ahmedqamesh/mopshub_readout/vivado/mopshub_readout/mopshub_readout/mopshub_readout.runs/mopshub_readout_bd_clk_wiz_0_0_synth_1/.vivado.begin.rst

<?xml version="1.0"?>
<ProcessHandle Version="1" Minor="0">
    <Process Command="vivado" Owner="dcs" Host="localhost.localdomain" Pid="18536" HostCore="8" HostMemory="32717760">
    </Process>
</ProcessHandle>
