ahmedqamesh/mopshub_readout/vivado/mopshub_readout/mopshub_readout/mopshub_readout.runs/mopshub_readout_bd_gig_ethernet_pcs_pma_0_0_synth_1/.Xil/mopshub_readout_bd_gig_ethernet_pcs_pma_0_0_propImpl.xdc

set_property SRC_FILE_INFO {cfile:/home/dcs/git/mopshub_readout/Vivado/mopshub_readout/mopshub_readout/mopshub_readout.gen/sources_1/bd/mopshub_readout_bd/ip/mopshub_readout_bd_gig_ethernet_pcs_pma_0_0/ip_0/synth/mopshub_readout_bd_gig_ethernet_pcs_pma_0_0_gt.xdc rfile:../../../mopshub_readout.gen/sources_1/bd/mopshub_readout_bd/ip/mopshub_readout_bd_gig_ethernet_pcs_pma_0_0/ip_0/synth/mopshub_readout_bd_gig_ethernet_pcs_pma_0_0_gt.xdc id:1 order:EARLY scoped_inst:inst/pcs_pma_block_i/transceiver_inst/mopshub_readout_bd_gig_ethernet_pcs_pma_0_0_gt_i/inst} [current_design]
set_property SRC_FILE_INFO {cfile:/home/dcs/git/mopshub_readout/Vivado/mopshub_readout/mopshub_readout/mopshub_readout.gen/sources_1/bd/mopshub_readout_bd/ip/mopshub_readout_bd_gig_ethernet_pcs_pma_0_0/synth/mopshub_readout_bd_gig_ethernet_pcs_pma_0_0.xdc rfile:../../../mopshub_readout.gen/sources_1/bd/mopshub_readout_bd/ip/mopshub_readout_bd_gig_ethernet_pcs_pma_0_0/synth/mopshub_readout_bd_gig_ethernet_pcs_pma_0_0.xdc id:2 order:LATE scoped_inst:inst} [current_design]
set_property src_info {type:SCOPED_XDC file:1 line:58 export:INPUT save:INPUT read:READ} [current_design]
set_case_analysis 1 [get_pins {inst/pcs_pma_block_i/transceiver_inst/mopshub_readout_bd_gig_ethernet_pcs_pma_0_0_gt_i/inst/gen_gtwizard_gthe4_top.mopshub_readout_bd_gig_ethernet_pcs_pma_0_0_gt_gtwizard_gthe4_inst/gen_gtwizard_gthe4.gen_channel_container[27].gen_enabled_channel.gthe4_channel_wrapper_inst/channel_inst/gthe4_channel_gen.gen_gthe4_channel_inst[0].GTHE4_CHANNEL_PRIM_INST/TXOUTCLKSEL[2]}]
set_property src_info {type:SCOPED_XDC file:1 line:59 export:INPUT save:INPUT read:READ} [current_design]
set_case_analysis 0 [get_pins {inst/pcs_pma_block_i/transceiver_inst/mopshub_readout_bd_gig_ethernet_pcs_pma_0_0_gt_i/inst/gen_gtwizard_gthe4_top.mopshub_readout_bd_gig_ethernet_pcs_pma_0_0_gt_gtwizard_gthe4_inst/gen_gtwizard_gthe4.gen_channel_container[27].gen_enabled_channel.gthe4_channel_wrapper_inst/channel_inst/gthe4_channel_gen.gen_gthe4_channel_inst[0].GTHE4_CHANNEL_PRIM_INST/TXOUTCLKSEL[1]}]
set_property src_info {type:SCOPED_XDC file:1 line:60 export:INPUT save:INPUT read:READ} [current_design]
set_case_analysis 1 [get_pins {inst/pcs_pma_block_i/transceiver_inst/mopshub_readout_bd_gig_ethernet_pcs_pma_0_0_gt_i/inst/gen_gtwizard_gthe4_top.mopshub_readout_bd_gig_ethernet_pcs_pma_0_0_gt_gtwizard_gthe4_inst/gen_gtwizard_gthe4.gen_channel_container[27].gen_enabled_channel.gthe4_channel_wrapper_inst/channel_inst/gthe4_channel_gen.gen_gthe4_channel_inst[0].GTHE4_CHANNEL_PRIM_INST/TXOUTCLKSEL[0]}]
set_property src_info {type:SCOPED_XDC file:1 line:63 export:INPUT save:INPUT read:READ} [current_design]
set_case_analysis 0 [get_pins {inst/pcs_pma_block_i/transceiver_inst/mopshub_readout_bd_gig_ethernet_pcs_pma_0_0_gt_i/inst/gen_gtwizard_gthe4_top.mopshub_readout_bd_gig_ethernet_pcs_pma_0_0_gt_gtwizard_gthe4_inst/gen_gtwizard_gthe4.gen_channel_container[27].gen_enabled_channel.gthe4_channel_wrapper_inst/channel_inst/gthe4_channel_gen.gen_gthe4_channel_inst[0].GTHE4_CHANNEL_PRIM_INST/RXOUTCLKSEL[2]}]
set_property src_info {type:SCOPED_XDC file:1 line:64 export:INPUT save:INPUT read:READ} [current_design]
set_case_analysis 1 [get_pins {inst/pcs_pma_block_i/transceiver_inst/mopshub_readout_bd_gig_ethernet_pcs_pma_0_0_gt_i/inst/gen_gtwizard_gthe4_top.mopshub_readout_bd_gig_ethernet_pcs_pma_0_0_gt_gtwizard_gthe4_inst/gen_gtwizard_gthe4.gen_channel_container[27].gen_enabled_channel.gthe4_channel_wrapper_inst/channel_inst/gthe4_channel_gen.gen_gthe4_channel_inst[0].GTHE4_CHANNEL_PRIM_INST/RXOUTCLKSEL[1]}]
set_property src_info {type:SCOPED_XDC file:1 line:65 export:INPUT save:INPUT read:READ} [current_design]
set_case_analysis 0 [get_pins {inst/pcs_pma_block_i/transceiver_inst/mopshub_readout_bd_gig_ethernet_pcs_pma_0_0_gt_i/inst/gen_gtwizard_gthe4_top.mopshub_readout_bd_gig_ethernet_pcs_pma_0_0_gt_gtwizard_gthe4_inst/gen_gtwizard_gthe4.gen_channel_container[27].gen_enabled_channel.gthe4_channel_wrapper_inst/channel_inst/gthe4_channel_gen.gen_gthe4_channel_inst[0].GTHE4_CHANNEL_PRIM_INST/RXOUTCLKSEL[0]}]
current_instance inst/pcs_pma_block_i/transceiver_inst/mopshub_readout_bd_gig_ethernet_pcs_pma_0_0_gt_i/inst
set_property src_info {type:SCOPED_XDC file:1 line:68 export:INPUT save:INPUT read:READ} [current_design]
set_property LOC GTHE4_CHANNEL_X1Y14 [get_cells -hierarchical -filter {NAME =~ *gen_channel_container[27].*gen_gthe4_channel_inst[0].GTHE4_CHANNEL_PRIM_INST}]
current_instance
set_property src_info {type:SCOPED_XDC file:1 line:84 export:INPUT save:INPUT read:READ} [current_design]
set_case_analysis 1 [get_pins {inst/pcs_pma_block_i/transceiver_inst/mopshub_readout_bd_gig_ethernet_pcs_pma_0_0_gt_i/inst/gen_gtwizard_gthe4_top.mopshub_readout_bd_gig_ethernet_pcs_pma_0_0_gt_gtwizard_gthe4_inst/gen_gtwizard_gthe4.gen_pwrgood_delay_inst[0].delay_powergood_inst/gen_powergood_delay.pwr_on_fsm_reg/Q}]
current_instance inst/pcs_pma_block_i/transceiver_inst/mopshub_readout_bd_gig_ethernet_pcs_pma_0_0_gt_i/inst
set_property src_info {type:SCOPED_XDC file:1 line:88 export:INPUT save:INPUT read:READ} [current_design]
create_waiver -internal -quiet -user gtwizard_ultrascale -tags 1025417 -type METHODOLOGY -id TIMING-3 -description "added waiver for CPLL CAL local BUFG_GT usecase"  -scope -objects [get_pins -filter {REF_PIN_NAME=~*O} -of_objects [get_cells -hierarchical -filter {NAME =~ *gen_cpll_cal_inst[*].*bufg_gt_*xoutclkmon_inst}]]
set_property src_info {type:SCOPED_XDC file:1 line:90 export:INPUT save:INPUT read:READ} [current_design]
create_waiver -internal -quiet -type CDC -id {CDC-11} -user gtwizard_ultrascale -tags "1074717" -description "CDC-11 waiver for CPLL Calibration logic" -scope -from [get_pins -quiet -filter {REF_PIN_NAME=~*C} -of_objects [get_cells -hierarchical -filter {NAME =~*OUTCLK_FREQ_COUNTER/state_reg[0]}]]  -to [get_pins -quiet -filter {REF_PIN_NAME=~*PRE} -of_objects [get_cells -hierarchical -filter {NAME =~*OUTCLK_FREQ_COUNTER/reset_synchronizer_testclk_rst_inst/rst_in_meta_reg*}]]
set_property src_info {type:SCOPED_XDC file:1 line:91 export:INPUT save:INPUT read:READ} [current_design]
create_waiver -internal -quiet -type CDC -id {CDC-11} -user gtwizard_ultrascale -tags "1074717" -description "CDC-11 waiver for CPLL Calibration logic" -scope -from [get_pins -quiet -filter {REF_PIN_NAME=~*C} -of_objects [get_cells -hierarchical -filter {NAME =~*OUTCLK_FREQ_COUNTER/state_reg[0]}]]  -to [get_pins -quiet -filter {REF_PIN_NAME=~*D} -of_objects [get_cells -hierarchical -filter {NAME =~*OUTCLK_FREQ_COUNTER/tstclk_rst_dly1_reg*}]]
current_instance
current_instance inst
set_property src_info {type:SCOPED_XDC file:2 line:18 export:INPUT save:INPUT read:READ} [current_design]
create_waiver -internal -scope -quiet -type CDC -id {CDC-10} -user "gig_ethernet_pcs_pma" -tags "11999" -desc "The CDC-10 warning is waived as this is within the GT Wizard" -from [get_pins -of [get_cells -hier -filter {name =~ */gpcs_pma_inst/USE_ROCKET_IO.RX_RST_SM_TXOUTCLK.MGT_RX_RESET_INT_reg*}] -filter {name =~ *C}] -to [get_pins -of [get_cells -hier -filter {name =~ */gen_gtwizard_*.gen_reset_controller_internal.gen_single_instance.gtwiz_reset_inst/reset_synchronizer_gtwiz_reset_rx_*_inst/rst_in_meta_reg*}] -filter {name =~ *PRE}]
set_property src_info {type:SCOPED_XDC file:2 line:22 export:INPUT save:INPUT read:READ} [current_design]
create_waiver -internal -scope -quiet -type CDC -id {CDC-10} -user "gig_ethernet_pcs_pma" -tags "11999" -desc "The CDC-10 warning is waived as this is within the GT Wizard" -from [get_pins -of [get_cells -hier -filter {name =~ */gpcs_pma_inst/USE_ROCKET_IO.MGT_TX_RESET_INT_reg*}] -filter {name =~ *C}] -to [get_pins -of [get_cells -hier -filter {name =~ */gen_gtwizard_*.gen_reset_controller_internal.gen_single_instance.gtwiz_reset_inst/reset_synchronizer_gtwiz_reset_tx_*_inst/rst_in_meta_reg*}] -filter {name =~ *PRE}]
set_property src_info {type:SCOPED_XDC file:2 line:26 export:INPUT save:INPUT read:READ} [current_design]
create_waiver -internal -scope -quiet -type CDC -id {CDC-10} -user "gig_ethernet_pcs_pma" -tags "11999" -desc "The CDC-10 warning is waived as this is within the GT Wizard" -from [get_pins -of [get_cells -hier -filter {name =~ */*_data_rx/reset_sync6*}] -filter {name =~ *C}] -to [get_pins -of [get_cells -hier -filter {name =~ */gen_gtwizard_*.gen_reset_controller_internal.gen_single_instance.gtwiz_reset_inst/reset_synchronizer_gtwiz_reset_*x_*_inst/rst_in_meta_reg*}] -filter {name =~ *PRE}]
set_property src_info {type:SCOPED_XDC file:2 line:30 export:INPUT save:INPUT read:READ} [current_design]
create_waiver -internal -scope -quiet -type CDC -id {CDC-10} -user "gig_ethernet_pcs_pma" -tags "11999" -desc "The CDC-10 warning is waived as this is within the GT Wizard" -from [get_pins -of [get_cells -hier -filter {name =~ */gen_gtwizard_*.gen_reset_controller_internal.gen_single_instance.gtwiz_reset_inst/reset_synchronizer_*x_done_inst/rst_in_out_reg*}] -filter {name =~ *C}] -to [get_pins -of [get_cells -hier -filter {name =~ */gen_gtwizard_*.gen_reset_controller_internal.gen_single_instance.gtwiz_reset_inst/reset_synchronizer_gtwiz_reset_*x_*_inst/rst_in_meta_reg*}] -filter {name =~ *PRE}]
set_property src_info {type:SCOPED_XDC file:2 line:33 export:INPUT save:INPUT read:READ} [current_design]
create_waiver -internal -scope -quiet -type CDC -id {CDC-12} -user "gig_ethernet_pcs_pma" -tags "11999" -desc "The CDC-12 warning is waived as this is within the GT Wizard" -from [get_pins -of [get_cells -hier -filter {name =~ */gen_gtwizard_*.gen_reset_controller_internal.gen_single_instance.gtwiz_reset_inst/reset_synchronizer_*x_done_inst/rst_in_out_reg*}] -filter {name =~ *C}] -to [get_pins -of [get_cells -hier -filter {name =~ */gen_gtwizard_*.gen_reset_controller_internal.gen_single_instance.gtwiz_reset_inst/reset_synchronizer_gtwiz_reset_*x_*_inst/rst_in_meta_reg*}] -filter {name =~ *PRE}]
set_property src_info {type:SCOPED_XDC file:2 line:36 export:INPUT save:INPUT read:READ} [current_design]
create_waiver -internal -scope -quiet -type CDC -id {CDC-10} -user "gig_ethernet_pcs_pma" -tags "11999" -desc "The CDC-10 warning is waived as this is within the GT Wizard" -from [get_pins -of [get_cells -hier -filter {name =~ */transceiver_inst/gtwiz_reset_*x_done_*_int_reg_reg*}] -filter {name =~ *C}] -to [get_pins -of [get_cells -hier -filter {name =~ */reset_synchronizer_gtwiz_reset_*x_*_inst/rst_in_meta_reg*}] -filter {name =~ *PRE}]
set_property src_info {type:SCOPED_XDC file:2 line:40 export:INPUT save:INPUT read:READ} [current_design]
create_waiver -internal -scope -quiet -type CDC -id {CDC-10} -user "gig_ethernet_pcs_pma" -tags "11999" -desc "The CDC-10 warning is waived as this is within the GT Wizard" -from [get_pins -of [get_cells -hier -filter {name =~ */reset_synchronizer_rx_done_inst/rst_in_out_reg*}] -filter {name =~ *C}] -to [get_pins -of [get_cells -hier -filter {name =~ */sync_block_reset_done/data_sync_reg1*}] -filter {name =~ *D}]
set_property src_info {type:SCOPED_XDC file:2 line:44 export:INPUT save:INPUT read:READ} [current_design]
create_waiver -internal -scope -quiet -type CDC -id {CDC-11} -user "gig_ethernet_pcs_pma" -tags "11999" -desc "The CDC-11 warning is waived as this is within the GT Wizard" -from [get_pins -of [get_cells -hier -filter {name =~ */U_TXOUTCLK_FREQ_COUNTER/state_reg[0]*}] -filter {name =~ *C}] -to [list [get_pins -of [get_cells -hier -filter {name =~ */U_TXOUTCLK_FREQ_COUNTER/reset_synchronizer_testclk_rst_inst/rst_in_meta_reg*}] -filter {name =~ *PRE}] [get_pins -of [get_cells -hier -filter {name =~ */U_TXOUTCLK_FREQ_COUNTER/tstclk_rst_dly1_reg*}] -filter {name =~ *D}] ]
set_property src_info {type:SCOPED_XDC file:2 line:48 export:INPUT save:INPUT read:READ} [current_design]
create_waiver -internal -scope -quiet -type CDC -id {CDC-10} -user "gig_ethernet_pcs_pma" -tags "11999" -desc "The CDC-10 warning is waived as this is within the GT Wizard" -from [get_pins -of [get_cells -hier -filter {name =~ */gen_gtwizard_*.gen_rx_buffer_bypass_internal.gen_single_instance.gtwiz_buffbypass_rx_inst/gen_gtwiz_buffbypass_rx_main.gen_auto_mode.gtwiz_buffbypass_rx_done_out_reg*}] -filter {name =~ *C}] -to [get_pins -of [get_cells -hier -filter {name =~ */sync_block_reset_done/data_sync_reg1*}] -filter {name =~ *D}]
set_property src_info {type:SCOPED_XDC file:2 line:50 export:INPUT save:INPUT read:READ} [current_design]
create_waiver -internal -scope -quiet -type CDC -id {CDC-10} -user "gig_ethernet_pcs_pma" -tags "11999" -desc "The CDC-10 warning is waived as this is within the GT Wizard" -from [get_pins -of [get_cells -hier -filter {name =~ */SYNC_UNIDIRECTIONAL_ENABLE_RXOUTCLK_INST/data_sync_reg6*}] -filter {name =~ *C}] -to [get_pins -of [get_cells -hier -filter {name =~ */SYNC_XMIT_*_TXOUTCLK/data_sync_reg1*}] -filter {name =~ *D}]
set_property src_info {type:SCOPED_XDC file:2 line:54 export:INPUT save:INPUT read:READ} [current_design]
create_waiver -internal -scope -quiet -type CDC -id {CDC-13} -user "gig_ethernet_pcs_pma" -tags "11999" -desc "The CDC-13 warning is waived as this is within the GT Wizard" -from [get_pins -of [get_cells -hier -filter {name =~ */reclock_encommaalign/reset_sync6*}] -filter {name =~ *C}] -to [get_pins -of [get_cells -hier -filter {name =~ */gt*_channel_gen.gen_gt*_channel_inst[0].GT*_CHANNEL_PRIM_INST*}] -filter {name =~ *RX*COMMAALIGNEN}]
set_property src_info {type:SCOPED_XDC file:2 line:56 export:INPUT save:INPUT read:READ} [current_design]
create_waiver -internal -scope -quiet -type CDC -id {CDC-10} -user "gig_ethernet_pcs_pma" -tags "11999" -desc "The CDC-10 warning is waived as this is within the GT Wizard" -from [get_pins  -of [get_cells -hier -filter {name =~ */reset_synchronizer_tx_done_inst/rst_in_out_reg*}] -filter {name =~ *C}] -to [get_pins  -of [get_cells -hier -filter {name =~ */sync_block_reset_done/data_sync_reg1*}] -filter {name =~ *D}]
