ahmedqamesh/mopshub_readout/vivado/mopshub_readout/mopshub_readout/mopshub_readout.runs/mopshub_readout_bd_mopshub_readout_0_0_synth_1/.Xil/mopshub_readout_bd_mopshub_readout_0_0_propImpl.xdc

set_property SRC_FILE_INFO {cfile:/home/dcs/git/mopshub_readout/Vivado/mopshub_readout/ip_repo/tri_mode_ethernet_mac_0/synth/tri_mode_ethernet_mac_0.xdc rfile:../../../../ip_repo/tri_mode_ethernet_mac_0/synth/tri_mode_ethernet_mac_0.xdc id:1 order:EARLY scoped_inst:inst/ethernet_core0/ethernet_emac_wrapper0/mac/inst} [current_design]
current_instance inst/ethernet_core0/ethernet_emac_wrapper0/mac/inst
set_property src_info {type:SCOPED_XDC file:1 line:51 export:INPUT save:INPUT read:READ} [current_design]
create_waiver -internal -scope -quiet -type CDC -id {CDC-11} -user "tri_mode_ethernet_mac" -tags "11999" -desc "Part of reset synchronizer. Safe to ignore" -from [get_pins -of [get_cells -hier -filter {name =~ */sync_stats_reset/sync_rst1_reg*}] -filter {name =~ *C}] -to [get_pins -of [get_cells -hier -filter {name =~ */SYNC_STATS_RESET/async_rst0_reg*}] -filter {name =~ *PRE}]
set_property src_info {type:SCOPED_XDC file:1 line:52 export:INPUT save:INPUT read:READ} [current_design]
create_waiver -internal -scope -quiet -type CDC -id {CDC-1} -user "tri_mode_ethernet_mac" -tags "11999" -desc "Safe to ignore. This data-bus is read-date port of the LUT based RAM whose read address is generated in the destination clock domain." -from [get_pins -of [get_cells -hier -filter {name =~ */byte_wide_ram[*].header_compare_dist_ram/DP*}] -filter {name =~ *CLK}] -to [get_pins -of [get_cells -hier -filter {name =~ */bit_match_gen[*].bit_match_reg[*]*}] -filter {name =~ *D}]
set_property src_info {type:SCOPED_XDC file:1 line:53 export:INPUT save:INPUT read:READ} [current_design]
create_waiver -internal -scope -quiet -type CDC -id {CDC-1} -user "tri_mode_ethernet_mac" -tags "11999" -desc "Safe to ignore. This data-bus is read-date port of the LUT based RAM whose read address is generated in the destination clock domain." -from [get_pins -of [get_cells -hier -filter {name =~ */man_block.managen/conf/int_rx_pause_ad_reg[*]*}] -filter {name =~ *C}] -to [get_pins -of [get_cells -hier -filter {name =~ */address_filter_inst/load_wr_data_reg[*]*}] -filter {name =~ *D}]
set_property src_info {type:SCOPED_XDC file:1 line:54 export:INPUT save:INPUT read:READ} [current_design]
create_waiver -internal -scope -quiet -type CDC -id {CDC-1} -user "tri_mode_ethernet_mac" -tags "11999" -desc "Control register o/p expected to be static during MAC operations and thus a false path for all practical purposes and thus can be ignored" -from [get_pins -of [get_cells -hier -filter {name =~ */man_block.managen/conf/int_rx_en_reg*}] -filter {name =~ *C}] -to [get_pins -of [get_cells -hier -filter {name =~ */rxgen/ENABLE_REG_reg*}] -filter {name =~ *D}]
set_property src_info {type:SCOPED_XDC file:1 line:55 export:INPUT save:INPUT read:READ} [current_design]
create_waiver -internal -scope -quiet -type CDC -id {CDC-1} -user "tri_mode_ethernet_mac" -tags "11999" -desc "Control register o/p expected to be static during MAC operations and thus a false path for all practical purposes and thus can be ignored" -from [get_pins -of [get_cells -hier -filter {name =~ */man_block.managen/conf/int_*x_inband_*_enable_reg*}] -filter {name =~ *C}]
