ahmedqamesh/mopshub_readout/vivado/mopshub_readout/mopshub_readout/mopshub_readout.cache/ip/2020.2/126f6c86148f7189/mopshub_readout_bd_gig_ethernet_pcs_pma_0_0_stub.v

// Copyright 1986-2020 Xilinx, Inc. All Rights Reserved.
// --------------------------------------------------------------------------------
// Tool Version: Vivado v.2020.2 (lin64) Build 3064766 Wed Nov 18 09:12:47 MST 2020
// Date        : Fri May  3 17:18:30 2024
// Host        : localhost.localdomain running 64-bit unknown
// Command     : write_verilog -force -mode synth_stub -rename_top decalper_eb_ot_sdeen_pot_pi_dehcac_xnilix -prefix
//               decalper_eb_ot_sdeen_pot_pi_dehcac_xnilix_ mopshub_readout_bd_gig_ethernet_pcs_pma_0_0_stub.v
// Design      : mopshub_readout_bd_gig_ethernet_pcs_pma_0_0
// Purpose     : Stub declaration of top-level module interface
// Device      : xczu9eg-ffvb1156-2-e
// --------------------------------------------------------------------------------

// This empty module with port declaration file causes synthesis tools to infer a black box for IP.
// The synthesis directives are for Synopsys Synplify support to prevent IO buffer insertion.
// Please paste the declaration into a Verilog source file or add the file as an additional source.
module decalper_eb_ot_sdeen_pot_pi_dehcac_xnilix(gtrefclk_p, gtrefclk_n, gtrefclk_out, txp, txn, 
  rxp, rxn, resetdone, userclk_out, userclk2_out, rxuserclk_out, rxuserclk2_out, 
  independent_clock_bufg, pma_reset_out, mmcm_locked_out, gmii_txd, gmii_tx_en, gmii_tx_er, 
  gmii_rxd, gmii_rx_dv, gmii_rx_er, gmii_isolate, configuration_vector, status_vector, reset, 
  gtpowergood, signal_detect)
/* synthesis syn_black_box black_box_pad_pin="gtrefclk_p,gtrefclk_n,gtrefclk_out,txp,txn,rxp,rxn,resetdone,userclk_out,userclk2_out,rxuserclk_out,rxuserclk2_out,independent_clock_bufg,pma_reset_out,mmcm_locked_out,gmii_txd[7:0],gmii_tx_en,gmii_tx_er,gmii_rxd[7:0],gmii_rx_dv,gmii_rx_er,gmii_isolate,configuration_vector[4:0],status_vector[15:0],reset,gtpowergood,signal_detect" */;
  input gtrefclk_p;
  input gtrefclk_n;
  output gtrefclk_out;
  output txp;
  output txn;
  input rxp;
  input rxn;
  output resetdone;
  output userclk_out;
  output userclk2_out;
  output rxuserclk_out;
  output rxuserclk2_out;
  input independent_clock_bufg;
  output pma_reset_out;
  output mmcm_locked_out;
  input [7:0]gmii_txd;
  input gmii_tx_en;
  input gmii_tx_er;
  output [7:0]gmii_rxd;
  output gmii_rx_dv;
  output gmii_rx_er;
  output gmii_isolate;
  input [4:0]configuration_vector;
  output [15:0]status_vector;
  input reset;
  output gtpowergood;
  input signal_detect;
endmodule
