ahmedqamesh/mopshub_readout/vivado/mopshub_readout/mopshub_readout/mopshub_readout.cache/ip/2020.2/2a71975ea8d23db0/mopshub_readout_bd_ila_0_0_stub.vhdl

-- Copyright 1986-2020 Xilinx, Inc. All Rights Reserved.
-- --------------------------------------------------------------------------------
-- Tool Version: Vivado v.2020.2 (lin64) Build 3064766 Wed Nov 18 09:12:47 MST 2020
-- Date        : Fri May  3 17:20:11 2024
-- Host        : localhost.localdomain running 64-bit unknown
-- Command     : write_vhdl -force -mode synth_stub -rename_top decalper_eb_ot_sdeen_pot_pi_dehcac_xnilix -prefix
--               decalper_eb_ot_sdeen_pot_pi_dehcac_xnilix_ mopshub_readout_bd_ila_0_0_stub.vhdl
-- Design      : mopshub_readout_bd_ila_0_0
-- Purpose     : Stub declaration of top-level module interface
-- Device      : xczu9eg-ffvb1156-2-e
-- --------------------------------------------------------------------------------
library IEEE;
use IEEE.STD_LOGIC_1164.ALL;

entity decalper_eb_ot_sdeen_pot_pi_dehcac_xnilix is
  Port ( 
    clk : in STD_LOGIC;
    probe0 : in STD_LOGIC_VECTOR ( 7 downto 0 );
    probe1 : in STD_LOGIC_VECTOR ( 7 downto 0 );
    probe2 : in STD_LOGIC_VECTOR ( 7 downto 0 );
    probe3 : in STD_LOGIC_VECTOR ( 7 downto 0 );
    probe4 : in STD_LOGIC_VECTOR ( 7 downto 0 )
  );

end decalper_eb_ot_sdeen_pot_pi_dehcac_xnilix;

architecture stub of decalper_eb_ot_sdeen_pot_pi_dehcac_xnilix is
attribute syn_black_box : boolean;
attribute black_box_pad_pin : string;
attribute syn_black_box of stub : architecture is true;
attribute black_box_pad_pin of stub : architecture is "clk,probe0[7:0],probe1[7:0],probe2[7:0],probe3[7:0],probe4[7:0]";
attribute X_CORE_INFO : string;
attribute X_CORE_INFO of stub : architecture is "ila,Vivado 2020.2";
begin
end;
