ahmedqamesh/mopshub_readout/vivado/mopshub_readout/mopshub_readout/mopshub_readout.gen/sources_1/bd/mopshub_readout_bd/ip/mopshub_readout_bd_proc_sys_reset_0_0/mopshub_readout_bd_proc_sys_reset_0_0_stub.vhdl

-- Copyright 1986-2020 Xilinx, Inc. All Rights Reserved.
-- --------------------------------------------------------------------------------
-- Tool Version: Vivado v.2020.2 (lin64) Build 3064766 Wed Nov 18 09:12:47 MST 2020
-- Date        : Fri May  3 17:18:14 2024
-- Host        : localhost.localdomain running 64-bit unknown
-- Command     : write_vhdl -force -mode synth_stub
--               /home/dcs/git/mopshub_readout/Vivado/mopshub_readout/mopshub_readout/mopshub_readout.gen/sources_1/bd/mopshub_readout_bd/ip/mopshub_readout_bd_proc_sys_reset_0_0/mopshub_readout_bd_proc_sys_reset_0_0_stub.vhdl
-- Design      : mopshub_readout_bd_proc_sys_reset_0_0
-- Purpose     : Stub declaration of top-level module interface
-- Device      : xczu9eg-ffvb1156-2-e
-- --------------------------------------------------------------------------------
library IEEE;
use IEEE.STD_LOGIC_1164.ALL;

entity mopshub_readout_bd_proc_sys_reset_0_0 is
  Port ( 
    slowest_sync_clk : in STD_LOGIC;
    ext_reset_in : in STD_LOGIC;
    aux_reset_in : in STD_LOGIC;
    mb_debug_sys_rst : in STD_LOGIC;
    dcm_locked : in STD_LOGIC;
    mb_reset : out STD_LOGIC;
    bus_struct_reset : out STD_LOGIC_VECTOR ( 0 to 0 );
    peripheral_reset : out STD_LOGIC_VECTOR ( 0 to 0 );
    interconnect_aresetn : out STD_LOGIC_VECTOR ( 0 to 0 );
    peripheral_aresetn : out STD_LOGIC_VECTOR ( 0 to 0 )
  );

end mopshub_readout_bd_proc_sys_reset_0_0;

architecture stub of mopshub_readout_bd_proc_sys_reset_0_0 is
attribute syn_black_box : boolean;
attribute black_box_pad_pin : string;
attribute syn_black_box of stub : architecture is true;
attribute black_box_pad_pin of stub : architecture is "slowest_sync_clk,ext_reset_in,aux_reset_in,mb_debug_sys_rst,dcm_locked,mb_reset,bus_struct_reset[0:0],peripheral_reset[0:0],interconnect_aresetn[0:0],peripheral_aresetn[0:0]";
attribute x_core_info : string;
attribute x_core_info of stub : architecture is "proc_sys_reset,Vivado 2020.2";
begin
end;
