ahmedqamesh/mopshub_readout/(commit log)

2024-03-04 UART (#4) and JTAG (#8) Interface designed
    [FTDI.kicad_sch, MOPS-Hub_Readout_board.kicad_pcb, MOPS-Hub_Readout_board.kicad_sch]
2024-03-04 #10: schematic design finished. Footprint started
    [MOPS-Hub_Readout_board.kicad_sch]
2024-03-05 eLink interface (#10) finished
    [MOPS-Hub_Readout_board.kicad_sch]
2024-03-05 #8: incorporated comparator IC for Power-on-JTAG
    [FTDI.kicad_sch]
2024-03-05 #2: Design of Ethernet port done
    [MOPS-Hub_Readout_board.kicad_sch]
2024-03-05 #38: RPI GPIO header in schematics integrated
    [MOPS-Hub_Readout_board.kicad_sch]
2024-03-05 #8: Marked unused Pins as such
    [FTDI.kicad_sch]
2024-03-06 Flash footprint changed to TSSOP-8
    [FTDI.kicad_sch, MOPS-Hub_Readout_board.kicad_sch]
2024-03-08 adding twiki
    [FTDI.kicad_sch, MOPS-Hub_Readout_board.kicad_pcb, MOPS-Hub_Readout_board.kicad_sch]
